mharisirfan/CPE342-MPI-Automed-System-that-plays-Chrome-Dino-Game-/README.md

# CPE342-MPI-Automed-System-that-plays-Chrome-Dino-Game-
