mharisirfan/CPE342-MPI-Automed-System-that-plays-Chrome-Dino-Game-/(list of files, drawings)

Other design files:
Mini Project 3/Mini Project 3/Mini Project-3/Simulations/2 LDRs Sim (Current Implementation).pdsprj
Mini Project 3/Mini Project 3/Mini Project-3/Simulations/Final Impleentation without Sensing.pdsprj
